rmpel/rpkeebs-suo-tx-numpad/production/bom.csv

Designator | Footprint | Quantity | Value | LCSC Part # | DigiKey | info
C1, C2, C3, C5 | 0805 | 4 | 10uF | C49010152 | CL21A106KOQNNNE
D1, D10, D11, D12, D13, D14, D15, D16, D17, D18, D19, D2, D20, D21, D3, D4, D5, D6, D7, D8, D9 | Diode_SOD-123 | 21 | D | C28646371 | 1N4148W-TP
F1 | 1206 | 1 | 1.5A | C28326719 | 1206L075THYR
J1 | USB_C_HRO_TYPE-C-31-M-12 | 1 | USB_C_Receptacle_USB2.0_16P | C2765186 | UJ20-C-H-G-SMT-1-P16-TR
LED1, LED10, LED11, LED12, LED13, LED14, LED15, LED16, LED17, LED18, LED19, LED2, LED20, LED21, LED22, LED3, LED4, LED5, LED6, LED7, LED8, LED9 | MX_SK6812MINI-E_REV | 22 | SK6803MINI-E-001 LCSC C5242955 | C5242955
MX1-MX21 | Hotswap_MX_Plated_1.00u | 21 | Macro1 | C5156480
R1, R2, R3, R4, R5, R6 | 0805 | 6 | 5K1 | C2930296 | RC0805FR-075K1L
SW1 | SW_Push_1P1T_NO_CK_KMR2 | 1 | BOOT | C221676 | PTS636SK25FSMTR LFS
U1 | QFN-48-1EP_7x7mm_P0.5mm_EP5.6x5.6mm_ThermalVias | 1 | STM32F411CEUx | C60420 | 497-14907-ND
U2 | SOT-23_Handsoldering | 1 | XC6206PxxxMR-Regulator_Linear | C5446 | XC6206P332MR-G
U3 | SOT-23-6_Handsoldering | 1 | USBLC6-2SC6 | C7519 | USBLC6-2SC6
UNDER1, UNDER10, UNDER11, UNDER12, UNDER2, UNDER3, UNDER4, UNDER5, UNDER6, UNDER7, UNDER8, UNDER9 | LED_SK6812MINI_PLCC4_3.5x3.5mm_P1.75mm | 12 | SK6812MINI LCSC C7423118 | C7423118 | S35353RGBSK6812MINID001
C4 | 0805 | 1 | 4.7uF | C277499
Y1 | Oscillator_SMD 3225 Active | 1 | XTAL OSC XO 25.0000MHZ HCMOS SMD |  |  | https://nl.aliexpress.com/item/1005007598126333.html
