rmpel/rpkeebs-suo-tx-numpad/SUO_TX_Numpad.kicad_pcb

## KiCad design SUO_TX_Numpad.kicad_pcb (2026-04-12)

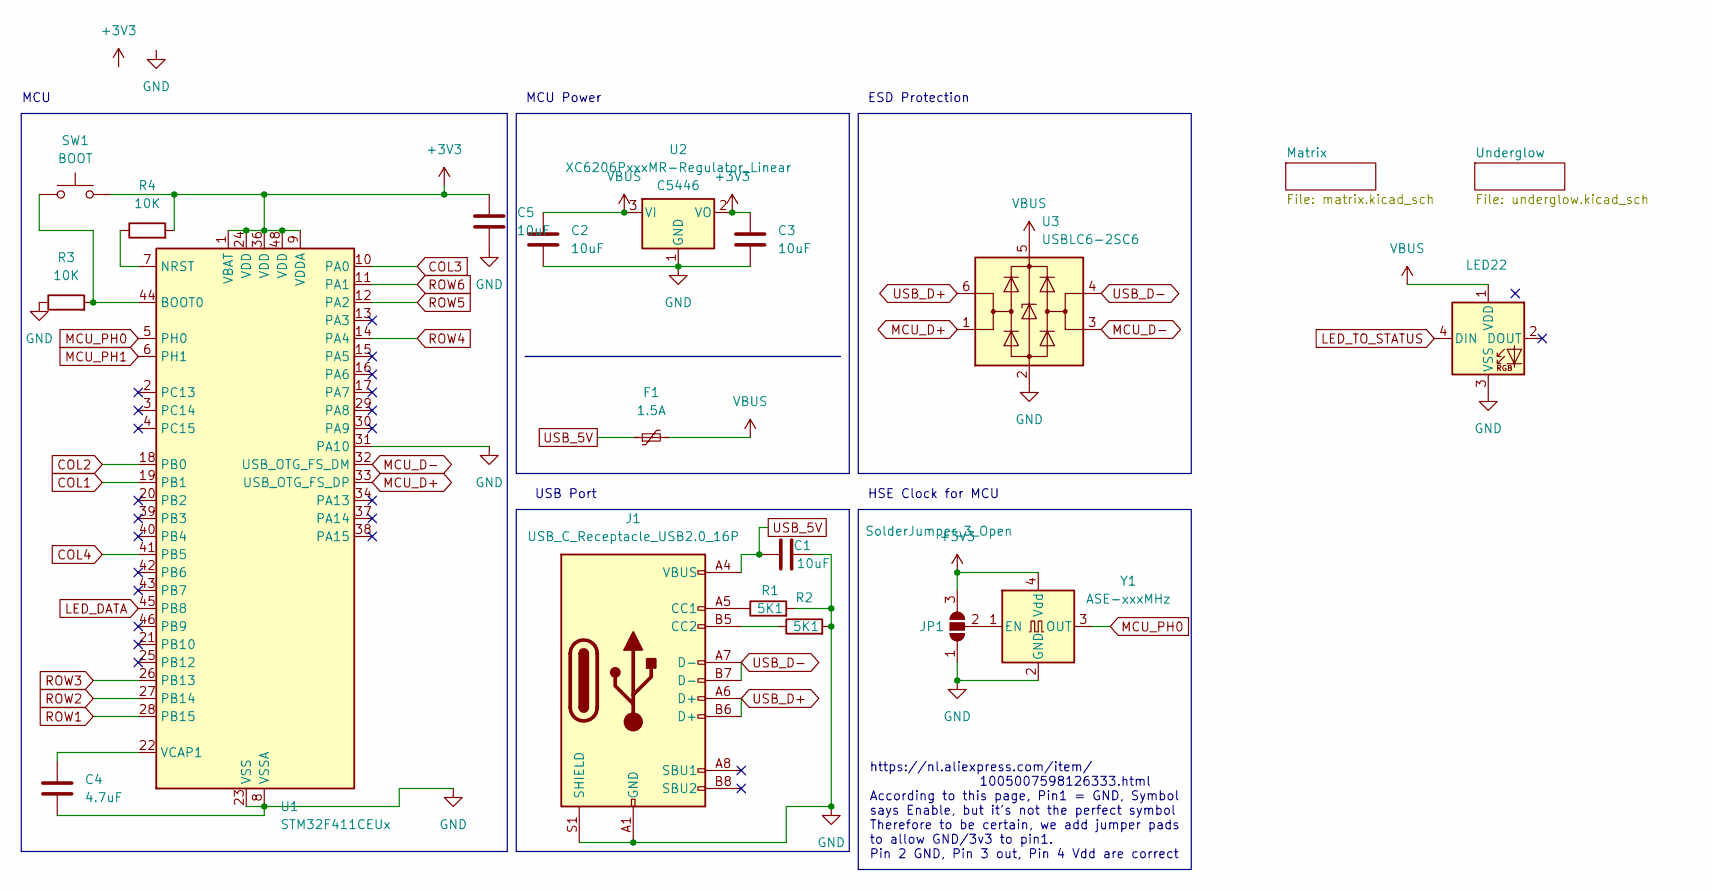
[picture p1: schematic SUO_TX_Numpad.kicad_sch]

Parts:
C1, C2, C3, C5: 10uF; C_0805_2012Metric_Pad1.18x1.45mm_HandSolder; LCSC C49010152
C4: 4.7uF; C_0805_2012Metric_Pad1.18x1.45mm_HandSolder; LCSC C277499
F1: 1.5A; Fuse_1206_3216Metric_Pad1.42x1.75mm_HandSolder; LCSC C28326719
J1: USB_C_Receptacle_USB2.0_16P; USB_C_HRO_TYPE-C-31-M-12; LCSC C2765186
JP1: SolderJumper_3_Open; SolderJumper-3_P1.3mm_Open_RoundedPad1.0x1.5mm
LED22: SK6803MINI-E-001 LCSC C5242955; MX_SK6812MINI-E_REV_ROTATED; LCSC C5242955
R1, R2: 5K1; R_0805_2012Metric_Pad1.20x1.40mm_HandSolder; LCSC C2930296
R3, R4: 10K; R_0805_2012Metric_Pad1.20x1.40mm_HandSolder; LCSC C2930231
SW1: BOOT; SW_Push_1P1T_NO_CK_KMR2; LCSC C221676
U1: STM32F411CEUx; QFN-48-1EP_7x7mm_P0.5mm_EP5.6x5.6mm_ThermalVias; LCSC C60420
U2: XC6206PxxxMR-Regulator_Linear; SOT-23_Handsoldering; LCSC C5446
U3: USBLC6-2SC6; SOT-23-6_Handsoldering; LCSC C7519
Y1: ASE-xxxMHz; Oscillator_SMD_Abracon_ASE-4Pin_3.2x2.5mm

Connections:
+3V3: C3.1, C5.1, JP1.3 (B), R4.2, SW1.2, U1.1 (VBAT), U1.9 (VDDA), U1.24 (VDD), U1.36 (VDD), U1.48 (VDD), U2.2 (VO), Y1.4 (Vdd)
COL1: U1.19 (PB1); also elsewhere on the board
COL2: U1.18 (PB0); also elsewhere on the board
COL3: U1.10 (PA0); also elsewhere on the board
COL4: U1.41 (PB5); also elsewhere on the board
GND: C1.2, C2.2, C3.2, C4.2, C5.2, J1.A1 (GND), J1.A12 (GND), J1.B1 (GND), J1.B12 (GND), J1.S1 (SHIELD), JP1.1 (A), LED22.3 (VSS), R1.2, R2.2, R3.1, U1.8 (VSSA), U1.23 (VSS), U1.31 (PA10), U1.35 (VSS), U1.47 (VSS), U1.49 (VSS), U2.1 (GND), U3.2 (GND), Y1.2 (GND); also elsewhere on the board
LED_DATA: U1.45 (PB8); also elsewhere on the board
LED_TO_STATUS: LED22.4 (DIN); also elsewhere on the board
MCU_D+: U1.33 (USB_OTG_FS_DP), U3.1 (I/O1)
MCU_D-: U1.32 (USB_OTG_FS_DM), U3.3 (I/O2)
MCU_PH0: U1.5 (PH0), Y1.3 (OUT)
MCU_PH1: U1.6 (PH1)
unnamed: J1.A5 (CC1), R1.1
unnamed: J1.B5 (CC2), R2.1
unnamed: JP1.2 (C), Y1.1 (EN)
unnamed: R3.2, SW1.1, U1.44 (BOOT0)
unnamed: R4.1, U1.7 (NRST)
unnamed: C4.1, U1.22 (VCAP1)
ROW1: U1.28 (PB15); also elsewhere on the board
ROW2: U1.27 (PB14); also elsewhere on the board
ROW3: U1.26 (PB13); also elsewhere on the board
ROW4: U1.14 (PA4); also elsewhere on the board
ROW5: U1.12 (PA2); also elsewhere on the board
ROW6: U1.11 (PA1); also elsewhere on the board
USB_5V: C1.1, F1.1, J1.A4 (VBUS), J1.A9 (VBUS), J1.B4 (VBUS), J1.B9 (VBUS)
USB_D+: J1.A6 (D+), J1.B6 (D+), U3.6 (I/O1)
USB_D-: J1.A7 (D-), J1.B7 (D-), U3.4 (I/O2)
VBUS: C2.1, F1.2, LED22.1 (VDD), U2.3 (VI), U3.5 (VBUS); also elsewhere on the board

Notes on the sheet:
HSE Clock for MCU
USB Port
https://nl.aliexpress.com/item/ 1005007598126333.html According to this page, Pin1 = GND, Symbol says Enable, but it's not the perfect symbol Therefore to be certain, we add jumper pads to allow GND/3v3 to pin1. Pin 2 GND, Pin 3 out, Pin 4 Vdd are correct
MCU
MCU Power
ESD Protection

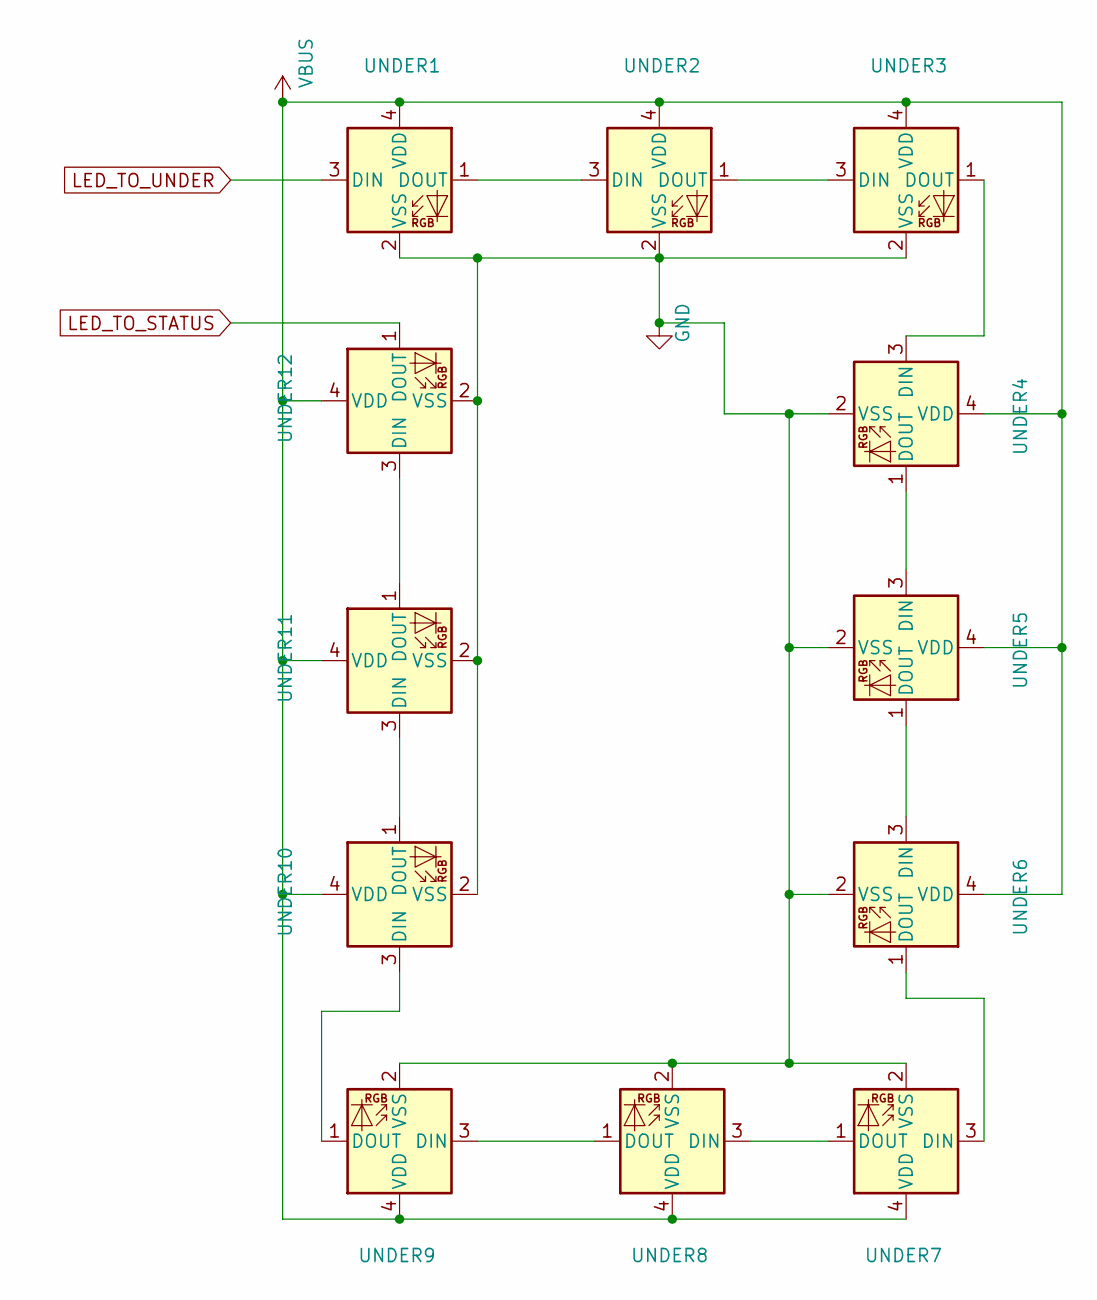
[picture p2: schematic underglow.kicad_sch]

Parts:
UNDER1, UNDER2, UNDER3, UNDER4, UNDER5, UNDER6, UNDER7, UNDER8, UNDER9, UNDER10, UNDER11, UNDER12: SK6812MINI LCSC C7423118; LED_SK6812MINI_PLCC4_3.5x3.5mm_P1.75mm; LCSC C7423118

Connections:
GND: UNDER1.2 (VSS), UNDER2.2 (VSS), UNDER3.2 (VSS), UNDER4.2 (VSS), UNDER5.2 (VSS), UNDER6.2 (VSS), UNDER7.2 (VSS), UNDER8.2 (VSS), UNDER9.2 (VSS), UNDER10.2 (VSS), UNDER11.2 (VSS), UNDER12.2 (VSS); also elsewhere on the board
LED_TO_STATUS: UNDER12.1 (DOUT); also elsewhere on the board
LED_TO_UNDER: UNDER1.3 (DIN); also elsewhere on the board
unnamed: UNDER1.1 (DOUT), UNDER2.3 (DIN)
unnamed: UNDER2.1 (DOUT), UNDER3.3 (DIN)
unnamed: UNDER3.1 (DOUT), UNDER4.3 (DIN)
unnamed: UNDER4.1 (DOUT), UNDER5.3 (DIN)
unnamed: UNDER5.1 (DOUT), UNDER6.3 (DIN)
unnamed: UNDER6.1 (DOUT), UNDER7.3 (DIN)
unnamed: UNDER7.1 (DOUT), UNDER8.3 (DIN)
unnamed: UNDER8.1 (DOUT), UNDER9.3 (DIN)
unnamed: UNDER9.1 (DOUT), UNDER10.3 (DIN)
unnamed: UNDER10.1 (DOUT), UNDER11.3 (DIN)
unnamed: UNDER11.1 (DOUT), UNDER12.3 (DIN)
VBUS: UNDER1.4 (VDD), UNDER2.4 (VDD), UNDER3.4 (VDD), UNDER4.4 (VDD), UNDER5.4 (VDD), UNDER6.4 (VDD), UNDER7.4 (VDD), UNDER8.4 (VDD), UNDER9.4 (VDD), UNDER10.4 (VDD), UNDER11.4 (VDD), UNDER12.4 (VDD); also elsewhere on the board

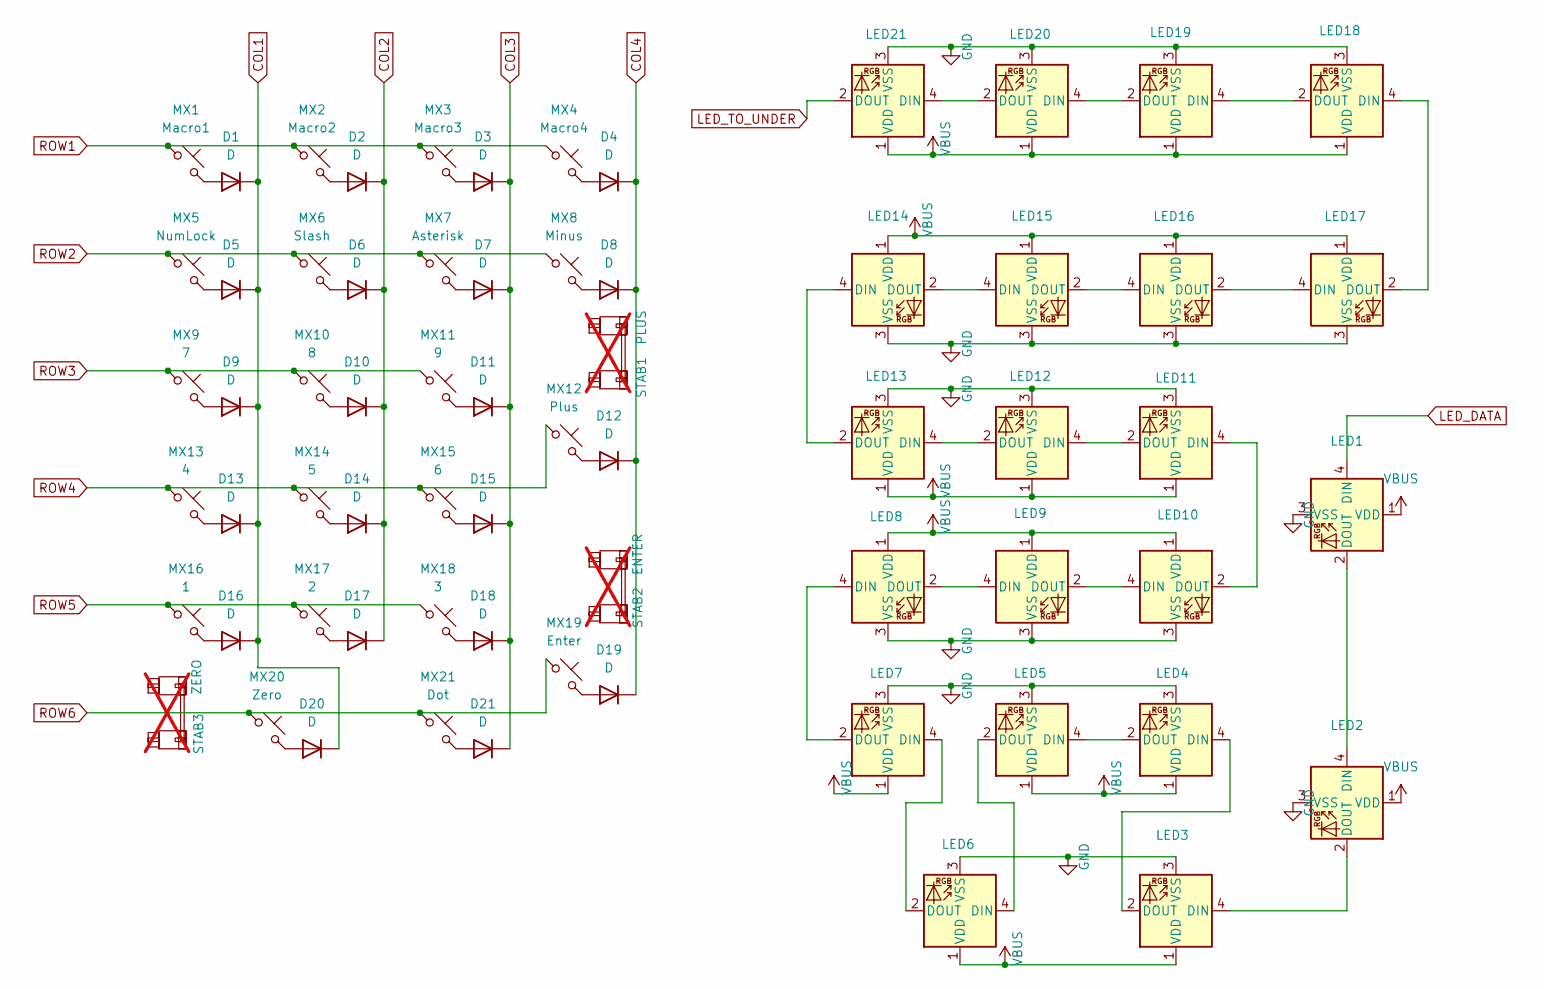
[picture p3: schematic matrix.kicad_sch]

Parts:
D1, D2, D3, D4, D5, D6, D7, D8, D9, D10, D11, D12, D13, D14, D15, D16, D17, D18, D19, D20, D21: D; Diode_SOD-123; LCSC C28646371
LED1, LED2, LED3, LED4, LED5, LED6, LED7, LED8, LED9, LED10, LED11, LED12, LED13, LED14, LED15, LED16, LED17, LED18, LED19, LED20, LED21: SK6803MINI-E-001 LCSC C5242955; MX_SK6812MINI-E_REV_ROTATED; LCSC C5242955
MX1: Macro1; Hotswap_MX_Plated_1.00u; LCSC C5156480
MX2: Macro2; Hotswap_MX_Plated_1.00u; LCSC C5156480
MX3: Macro3; Hotswap_MX_Plated_1.00u; LCSC C5156480
MX4: Macro4; Hotswap_MX_Plated_1.00u; LCSC C5156480
MX5: NumLock; Hotswap_MX_Plated_1.00u; LCSC C5156480
MX6: Slash; Hotswap_MX_Plated_1.00u; LCSC C5156480
MX7: Asterisk; Hotswap_MX_Plated_1.00u; LCSC C5156480
MX8: Minus; Hotswap_MX_Plated_1.00u; LCSC C5156480
MX9: 7; Hotswap_MX_Plated_1.00u; LCSC C5156480
MX10: 8; Hotswap_MX_Plated_1.00u; LCSC C5156480
MX11: 9; Hotswap_MX_Plated_1.00u; LCSC C5156480
MX12: Plus; Hotswap_MX_Plated_2.00u; LCSC C5156480
MX13: 4; Hotswap_MX_Plated_1.00u; LCSC C5156480
MX14: 5; Hotswap_MX_Plated_1.00u; LCSC C5156480
MX15: 6; Hotswap_MX_Plated_1.00u; LCSC C5156480
MX16: 1; Hotswap_MX_Plated_1.00u; LCSC C5156480
MX17: 2; Hotswap_MX_Plated_1.00u; LCSC C5156480
MX18: 3; Hotswap_MX_Plated_1.00u; LCSC C5156480
MX19: Enter; Hotswap_MX_Plated_2.00u; LCSC C5156480
MX20: Zero; Hotswap_MX_Plated_2.00u; LCSC C5156480
MX21: Dot; Hotswap_MX_Plated_1.00u; LCSC C5156480
STAB1: PLUS; Stabilizer_MX_2.00u; not fitted
STAB2: ENTER; Stabilizer_MX_2.00u; not fitted
STAB3: ZERO; Stabilizer_MX_2.00u; not fitted

Connections:
COL1: D1.1 (K), D5.1 (K), D9.1 (K), D13.1 (K), D16.1 (K), D20.1 (K); also elsewhere on the board
COL2: D2.1 (K), D6.1 (K), D10.1 (K), D14.1 (K), D17.1 (K); also elsewhere on the board
COL3: D3.1 (K), D7.1 (K), D11.1 (K), D15.1 (K), D18.1 (K), D21.1 (K); also elsewhere on the board
COL4: D4.1 (K), D8.1 (K), D12.1 (K), D19.1 (K); also elsewhere on the board
GND: LED1.3 (VSS), LED2.3 (VSS), LED3.3 (VSS), LED4.3 (VSS), LED5.3 (VSS), LED6.3 (VSS), LED7.3 (VSS), LED8.3 (VSS), LED9.3 (VSS), LED10.3 (VSS), LED11.3 (VSS), LED12.3 (VSS), LED13.3 (VSS), LED14.3 (VSS), LED15.3 (VSS), LED16.3 (VSS), LED17.3 (VSS), LED18.3 (VSS), LED19.3 (VSS), LED20.3 (VSS), LED21.3 (VSS); also elsewhere on the board
LED_DATA: LED1.4 (DIN); also elsewhere on the board
LED_TO_UNDER: LED21.2 (DOUT); also elsewhere on the board
unnamed: D1.2 (A), MX1.2
unnamed: D2.2 (A), MX2.2
unnamed: D3.2 (A), MX3.2
unnamed: D4.2 (A), MX4.2
unnamed: D5.2 (A), MX5.2
unnamed: D6.2 (A), MX6.2
unnamed: D7.2 (A), MX7.2
unnamed: D8.2 (A), MX8.2
unnamed: D9.2 (A), MX9.2
unnamed: D10.2 (A), MX10.2
unnamed: D11.2 (A), MX11.2
unnamed: D12.2 (A), MX12.2
unnamed: D13.2 (A), MX13.2
unnamed: D14.2 (A), MX14.2
unnamed: D15.2 (A), MX15.2
unnamed: D16.2 (A), MX16.2
unnamed: D17.2 (A), MX17.2
unnamed: D18.2 (A), MX18.2
unnamed: D19.2 (A), MX19.2
unnamed: D20.2 (A), MX20.2
unnamed: D21.2 (A), MX21.2
unnamed: LED1.2 (DOUT), LED2.4 (DIN)
unnamed: LED2.2 (DOUT), LED3.4 (DIN)
unnamed: LED3.2 (DOUT), LED4.4 (DIN)
unnamed: LED4.2 (DOUT), LED5.4 (DIN)
unnamed: LED5.2 (DOUT), LED6.4 (DIN)
unnamed: LED6.2 (DOUT), LED7.4 (DIN)
unnamed: LED7.2 (DOUT), LED8.4 (DIN)
unnamed: LED8.2 (DOUT), LED9.4 (DIN)
unnamed: LED9.2 (DOUT), LED10.4 (DIN)
unnamed: LED10.2 (DOUT), LED11.4 (DIN)
unnamed: LED11.2 (DOUT), LED12.4 (DIN)
unnamed: LED12.2 (DOUT), LED13.4 (DIN)
unnamed: LED13.2 (DOUT), LED14.4 (DIN)
unnamed: LED14.2 (DOUT), LED15.4 (DIN)
unnamed: LED15.2 (DOUT), LED16.4 (DIN)
unnamed: LED16.2 (DOUT), LED17.4 (DIN)
unnamed: LED17.2 (DOUT), LED18.4 (DIN)
unnamed: LED18.2 (DOUT), LED19.4 (DIN)
unnamed: LED19.2 (DOUT), LED20.4 (DIN)
unnamed: LED20.2 (DOUT), LED21.4 (DIN)
ROW1: MX1.1, MX2.1, MX3.1, MX4.1; also elsewhere on the board
ROW2: MX5.1, MX6.1, MX7.1, MX8.1; also elsewhere on the board
ROW3: MX9.1, MX10.1, MX11.1; also elsewhere on the board
ROW4: MX12.1, MX13.1, MX14.1, MX15.1; also elsewhere on the board
ROW5: MX16.1, MX17.1, MX18.1; also elsewhere on the board
ROW6: MX19.1, MX20.1, MX21.1; also elsewhere on the board
VBUS: LED1.1 (VDD), LED2.1 (VDD), LED3.1 (VDD), LED4.1 (VDD), LED5.1 (VDD), LED6.1 (VDD), LED7.1 (VDD), LED8.1 (VDD), LED9.1 (VDD), LED10.1 (VDD), LED11.1 (VDD), LED12.1 (VDD), LED13.1 (VDD), LED14.1 (VDD), LED15.1 (VDD), LED16.1 (VDD), LED17.1 (VDD), LED18.1 (VDD), LED19.1 (VDD), LED20.1 (VDD), LED21.1 (VDD); also elsewhere on the board

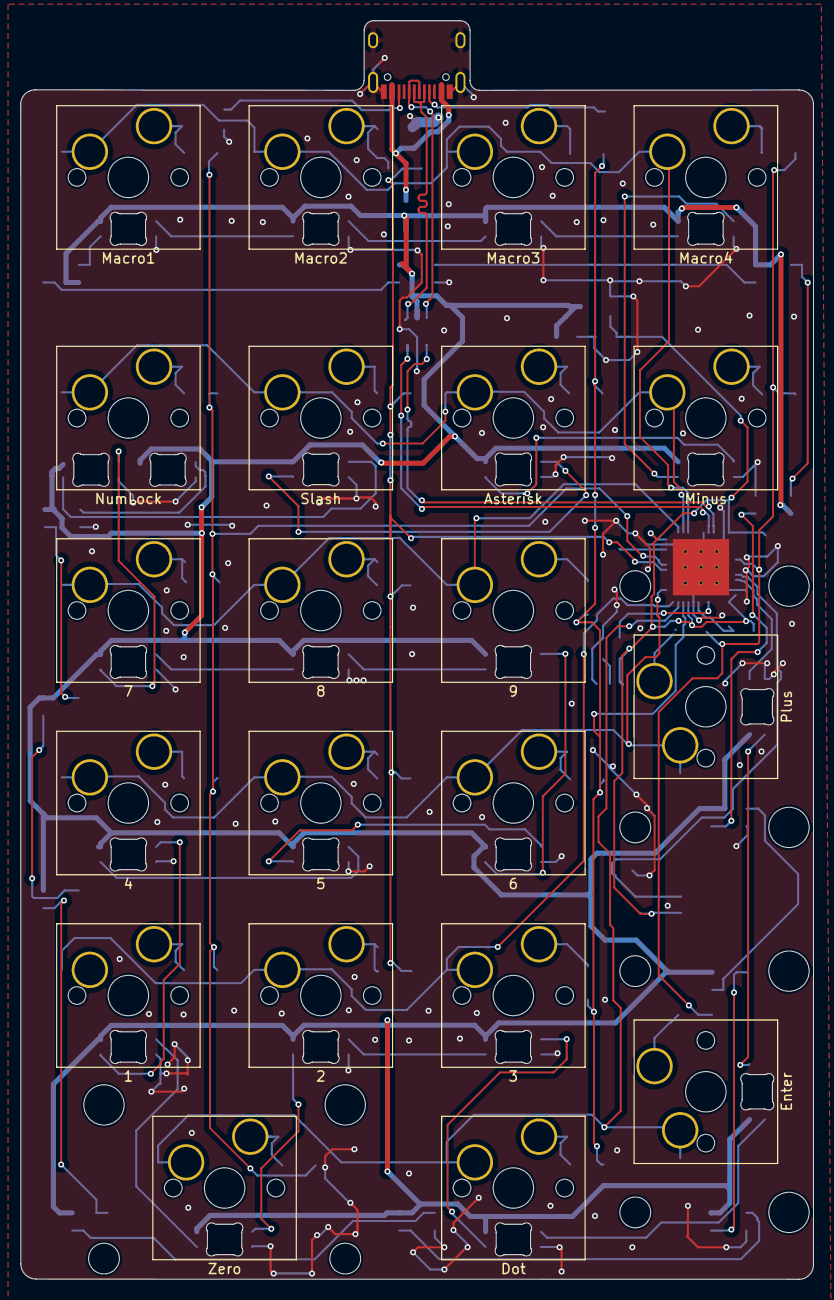
[picture p4: board SUO_TX_Numpad.kicad_pcb from above]

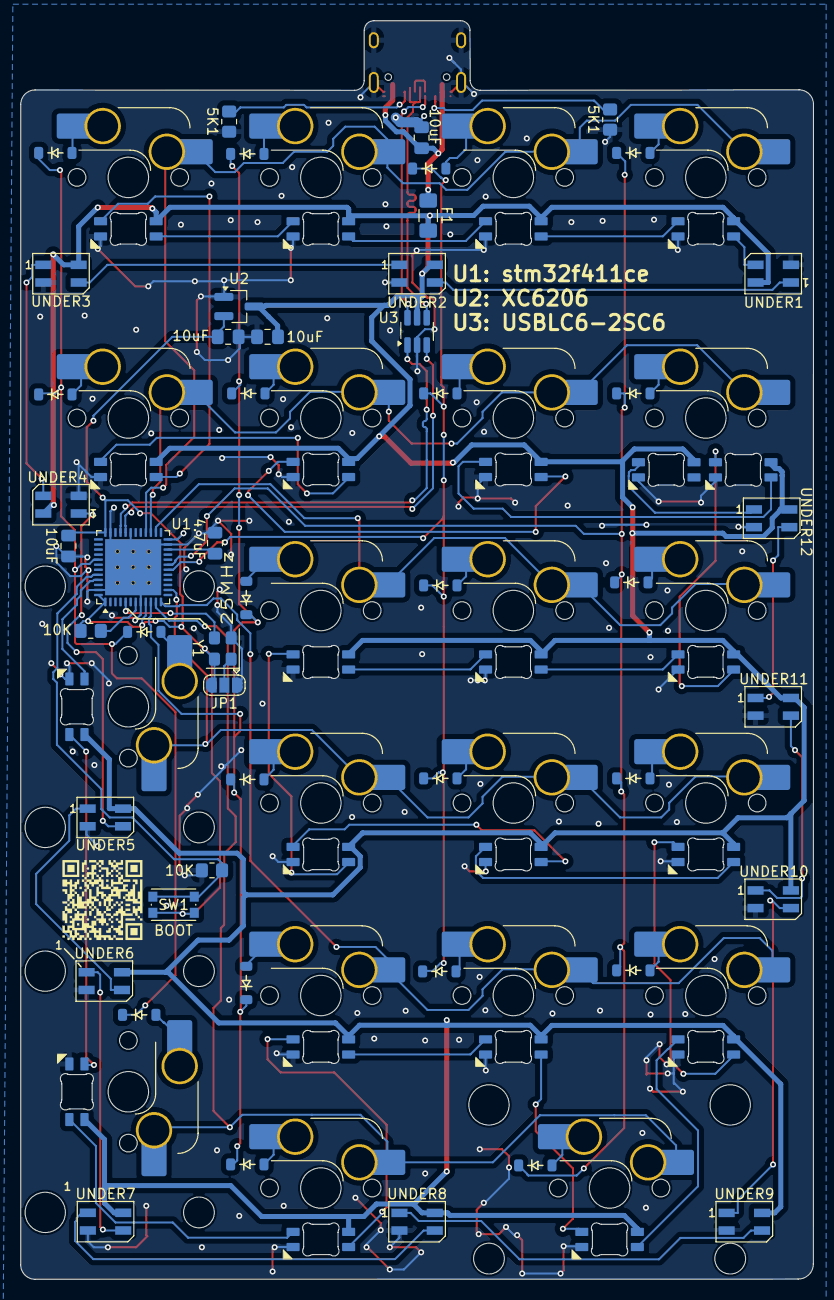
[picture p5: board SUO_TX_Numpad.kicad_pcb from below]

Board: 2 copper layers, 78.5 x 124.6 mm, 96 parts (49 on the bottom side), 80 nets.
