rmpel/rpkeebs-suo-tx-numpad/(commit log)

2026-03-22 Routing done, violations handled, Silk screen cleaned up
    [SUO_TX_Numpad.kicad_pcb]
2026-03-22 Add QR to silk
    [SUO_TX_Numpad.kicad_pcb]
2026-03-23 Added LCSC, but going to switch to 0603 or 0804 components as I want to keep handsoldering an option
    [SUO_TX_Numpad.kicad_pcb, SUO_TX_Numpad.kicad_sch, matrix.kicad_sch, underglow.kicad_sch]
2026-03-23 Switched to 0805 for R C and SOD-123 for Diodes
    [SUO_TX_Numpad.kicad_pcb, SUO_TX_Numpad.kicad_sch, matrix.kicad_sch]
2026-03-23 Add production files - make note - the BOM seems totally incorrect
    [bom.csv, designators.csv, positions.csv]
2026-03-24 Updated BOM
    [SUO_TX_Numpad.kicad_pcb, SUO_TX_Numpad.kicad_sch, bom.csv]
2026-03-26 Wrong diode package/type in bom C917030 is 1N4148w SOD-123 switching diode
    [bom.csv]
2026-03-29 PCB Layout altered to be exact to a SUO TX TKL board, Y-dimensions-wise
    [SUO_TX_Numpad.kicad_pcb]
2026-03-30 Made board slightly smaller, un-rotated the plus and enter stabilisers, they are supposed to go inward and not outward
    [SUO_TX_Numpad.kicad_pcb, bom.csv, positions.csv]
2026-03-31 manually updated BOM for DigiKey support
    [bom.csv]
2026-03-31 Added fixed copy of bom for future reference
    [bom-fixed.csv]
2026-04-03 Fixed VCAP1 Value to 4.7 uF, added XTAL 8 MHz
    [SUO_TX_Numpad.kicad_pcb, SUO_TX_Numpad.kicad_sch]
2026-04-06 Pulled A10 to ground; found that a BlackPill dev board wo'nt DFU properly without it. Updated SK6812MINI-E footprint to be a rotated one; track layout stays the same, but the old footprint was incorr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
    [SUO_TX_Numpad.kicad_pcb, SUO_TX_Numpad.kicad_sch, matrix.kicad_sch]
2026-04-06 Added freqency marker for HCMOS XTAL
    [SUO_TX_Numpad.kicad_pcb]
2026-04-06 Updated production files.
    [bom.csv, designators.csv, positions.csv]
2026-04-09 Added 3225 active oscillator, unsure if pin 1 is in fact enable, is in fact active high, so a jumper pad to pick either is added
    [SUO_TX_Numpad.kicad_pcb, SUO_TX_Numpad.kicad_sch, bom.csv, designators.csv, positions.csv]
2026-04-12 Fixed wiring mistake on USBLC6-2SC6
    [SUO_TX_Numpad.kicad_pcb, SUO_TX_Numpad.kicad_sch]
